eSpark-Consulting-Group/cooper-scarbrough-log-n-controller/Client-Files/Project Data_4.30.24/LogN Controller BOD REV1_4.20.24.pdf

Operator Engagement

1

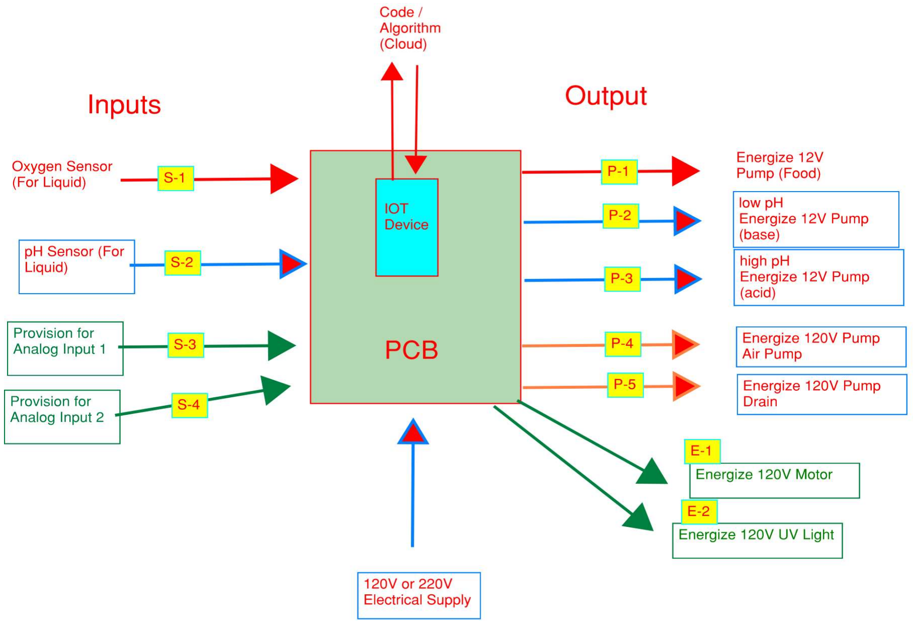
[picture p7: figure]

Operator Selects Script interacting with the Controller. (Simple Programmable Screen with Button Interface)
2

### 3 Operator Selects 'RUN' (Button Interface)

4

### 5 Script is followed per Parameters/Variables

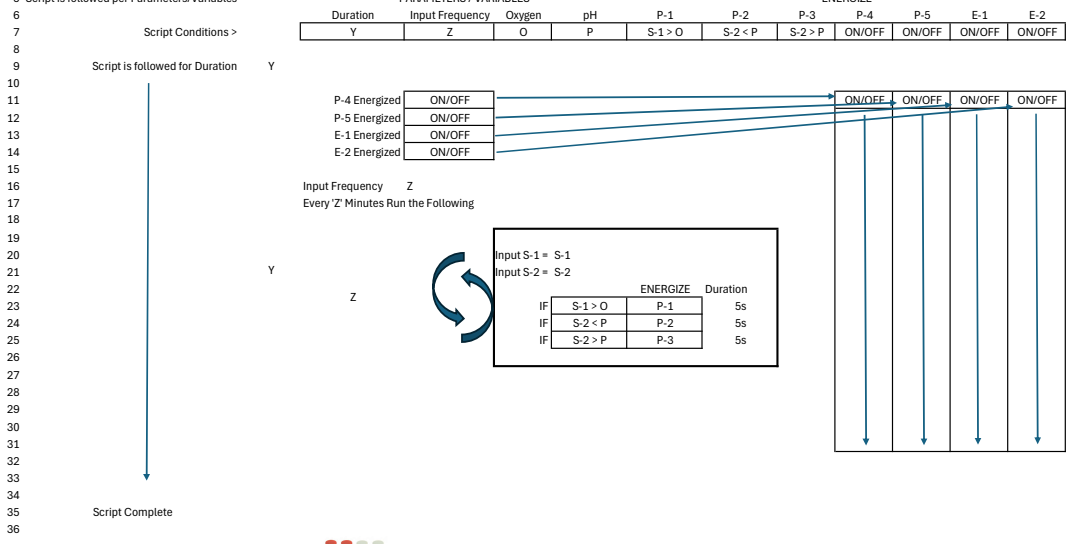
[picture p8: figure]
Duration; Input Frequency Oxygen; Script Conditions >; ON/OFF; Script is followed for Duration; P-4 Energized; P-5 Energized; E-1 Energized; E-2 Energized; Input Frequency; 17 Every 'Z' Minutes Run the Following 18 19 20 Input S-1 = S-1 21 Input S-2 = S-2 22 ENERGIZE Duration; 26 27 28 29 30 31 32 33 34 35 Script Complete 36

### 37 Operator Select 'END' to clear cache

ENERGIZE

CODE BASE
Parameters/Variables > | Duration | Input Frequency | Oxygen | pH | ENERGIZE
Script Name | Y | Z | O | P | P-1 | P-2 | P-3 | P-4 | P-5 | E-1 | E-2
Microbe 1 | | | | | S-1 > O | S-2 < P | S-2 > P | ON | ON | ON | OFF
Microbe 2 | | | | | S-1 > O | S-2 < P | S-2 > P | ON | ON | ON | OFF
Microbe 3 | | | | | S-1 > O | S-2 < P | S-2 > P | ON | ON | ON | OFF
CT-1 | | | | | S-1 > O | S-2 < P | S-2 > P | ON | ON | ON | OFF
CT-2 | | | | | S-1 > O | S-2 < P | S-2 > P | ON | ON | ON | OFF
Sterilization | n/a | n/a | n/a | n/a | n/a | n/a | n/a | OFF | OFF | ON | ON

PARAMETERS / VARIABLES

PERFORMANCE RUN
Code Base
