eSpark-Consulting-Group/cooper-scarbrough-log-n-controller/docs/Dev-Files/Production Enclosure Materials List/Cooper Panel Box Listing.docx

Cooper Panel Box Listing

1. Customised Acrylic window for LCD
2. Screen printing on front & side panel
3. Push Button knobs (Grey color) [10 Pcs]
4. M3x6mm & M3x10mm Male to Female standoff PCB Brass spacer [10 Pcs each]
5. U type 4mm Lugs [50 Pcs]
6. O type 4mm Lugs [50 Pcs]
7. Pipe 2.5mm Lugs [50 Pcs]
8. Lugs plier
9. Rivets M5x6mm & M3x6mm (Grey Color) [50 Pcs each]
10. Rivets plier
11. Glands PG9 & PG11 (Grey Color) [10 Pcs each]
12. 16x38mm Dura slot duct (Grey Color) Adamjee
13. Flexible pipe ½ inch & ¾ inch (Grey Color) [5 ft each] Adamjee
14. Spiral wrap ½ inch & ¾ inch (Grey Color) [5 ft each] Adamjee
15. Marker label tags (0-9 & A-Z)
16. Countersunk SS screw M3x5mm with SS nuts [24 Pcs each]
17. Round head SS screw M5x10mm [24 Pcs]
18. Industrial handle for Electrical panel box as per sample
19. Flexible wire 2.5mm & 10mm single core [10m each]
20. Stranded wire 4mm & 6mm [5m each]
21. Heat Shrink pipe (Red, Yellow, Blue and Black Color) [15 ft each]

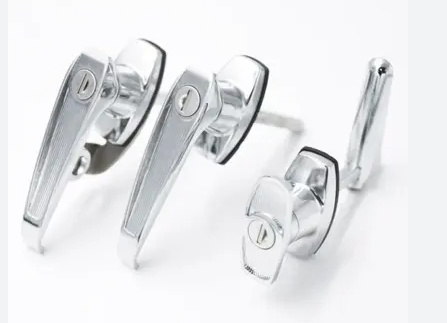
[picture p9: figure]
