eSpark-Consulting-Group/cooper-scarbrough-log-n-controller/Client-Files/Project Data_4.30.24/Production Data/BOM_Oxy_PH_Sensor_2024-04-30.csv

ID | Name | Designator | Footprint | Quantity | Manufacturer Part | Manufacturer | Supplier | Supplier Part | Price
1 | HDR-F-2.54_1x2 | H4,H5,H6,H2 | HDR-F-2.54_1X2 | 4 |  |  | LCSC | C49661 | 0.034
2 | 10kΩ | U15,U16,U17 | R0603 | 3 | PTFR0603B10K0N9 | RESI(开步睿思） | LCSC | C394535 | 0.142
3 | 10uF | C1,C5 | CAP-SMD_L3.5-W2.8-R-RD | 2 | CA45-B-25V-10uF-M | CEC(振华新云) | LCSC | C140404 | 0.124
4 | 100nF | C2,C4 | C0805 | 2 | CT41G-0805-2X1-50V-0.1μF-K(N) | TORCH(火炬) | LCSC | C126469 | 0.005
5 | 1nF | C3,C6 | CAP-TH_L8.5-W6.0_CT81-400VAC-08D-2E4-102M-YA | 2 | CT81-400VAC-08d-2E4-102M-YA 3.5d | LY(鲁颖) | LCSC | C2890520
6 | 100nF | C7 | CAP-TH_L18.0-W7.0-P15.00-D0.7 | 1 | X2-104K-275VAC | NDF(达孚) | LCSC | C914484 | 0.035
7 | DB128V-5.0-6P | CN1 | CONN-TH_6P-P5.00_DB128V | 1 | DB128V-5.0-6P-GN-S | DORABO(地博电气) | LCSC | C424686 | 0.475
8 | P4SMA15CA | D1 | SMA_L4.4-W2.6-LS5.0-BI | 1 | P4SMA15CA | Littelfuse(美国力特) | LCSC | C151192 | 0.127
9 | 210S-1*2P L=11.6MMGold-plated black | H1,H3 | HDR-TH_2P-P2.54-V-M-1 | 2 | B-2100S02P-A110 | Ckmtw(灿科盟) | LCSC | C124375 | 0.022
10 | Techtonics PH Sensor | J1 | HDR-M-2.54_1X6 | 1 |  |  | LCSC | C190819 | 0.029
11 | SEN0322 | J2 | HDR-M-2.54_1X4 | 1 |  |  | LCSC | C124378 | 0.04
12 | FC-HLF2018-15MH-10A-LF | L3 | FILTER-TH_4P-L22.0-W14.0-TL | 1 | FC-HLF2018-15mH-10A-LF | FC(方成) | LCSC | C5142780 | 2.062
13 | FTR14D471K | R1 | RES-TH_L16.0-W5.4-P7.50-D0.8-S4.60 | 1 | FTR14D471K | FTR(乔光电子) | LCSC | C693460 | 0.08
14 | 100Ω | R2,R3,R4,R5,R6,R7,R8,R9,R10,R11,R12,R13,R14,R15 | R0603 | 14 | QR0603F100RP05Z | EVER OHMS(天二科技) | LCSC | C176127 | 0.004
15 | SRD-05VDC-SL-C | RLY1,RLY2,RLY3,RLY4,RLY5,RLY6,RLY7 | RELAY-TH_SRD-XXVDC-XL-C | 7 | SRD-05VDC-SL-C | 松乐 | LCSC | C35449 | 0.306
16 | 0251004.NRT1L | U1,U6 | FUSE-TH_BD3.0-L7.2-P11.20-D0.6 | 2 | 0251004.NRT1L | Littelfuse(美国力特) | LCSC | C178929 | 0.158
17 | DB128L-5.0-2P-GY-S | U2 | CONN-TH_2P-P5.00_DB128L-5.0-2P-GY-S | 1 | DB128L-5.0-2P-GY-S | DORABO(地博电气) | LCSC | C430598 | 0.181
18 | TLP187(TPL,E(T | U3,U8,U9,U11,U12,U13,U14 | OPTO-SMD-4_L3.7-W4.6-P2.54-LS7.0-BR-2 | 7 | TLP187(TPL,E | TOSHIBA(东芝) | LCSC | C50180 | 0.433
19 | ESP32-DEVKITC-32D | U4 | COMM-SMD_ESP32-DEVKITC-32D | 1 | ESP32-DevKitC-32D | ESPRESSIF(乐鑫) | LCSC | C571181 | 12.402
20 | IRM-10-5 | U5 | PWRM-TH_4P-L45.7-W25.4-P8.0 | 1 | IRM-10-5 | MW(明纬) | LCSC | C2857903 | 5.115
21 | LDE15-20B12 | U7 | PWRM-TH_LDE15-20BXX | 1 | LDE15-20B12 | MORNSUN(金升阳) | LCSC | C970785 | 9.178
22 | DB128V-5.0-8P | U10 | CONN-TH_8P-P5.00_DB128V-5.0-8P | 1 | DB128V-5.0-8P-GN-S | DORABO(地博电气) | LCSC | C395863 | 0.567
23 | 4.7uH | L2 | IND-TH_BD7.0-P2.50-D0.7 | 1 | PK0608-4R7MB | SXN(顺翔诺) | LCSC | C400294 | 0.048
