eSpark-Consulting-Group/cooper-scarbrough-log-n-controller/Client-Files/Project Data_4.30.24/Schematic_Oxy_PH_Sensor_2024-04-30.pdf

AC-DC 5VDC | AC-DC 12VDC

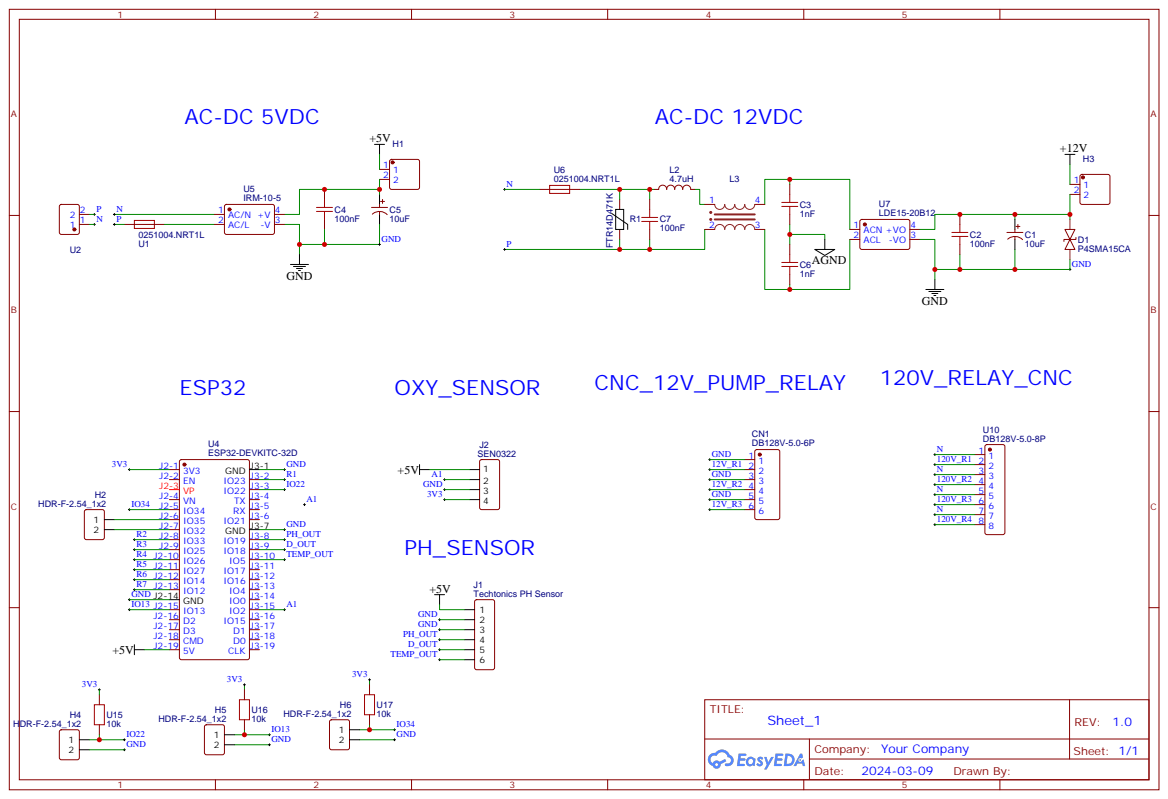
[picture p10: page 1]

# OPTO_12V_PUMP

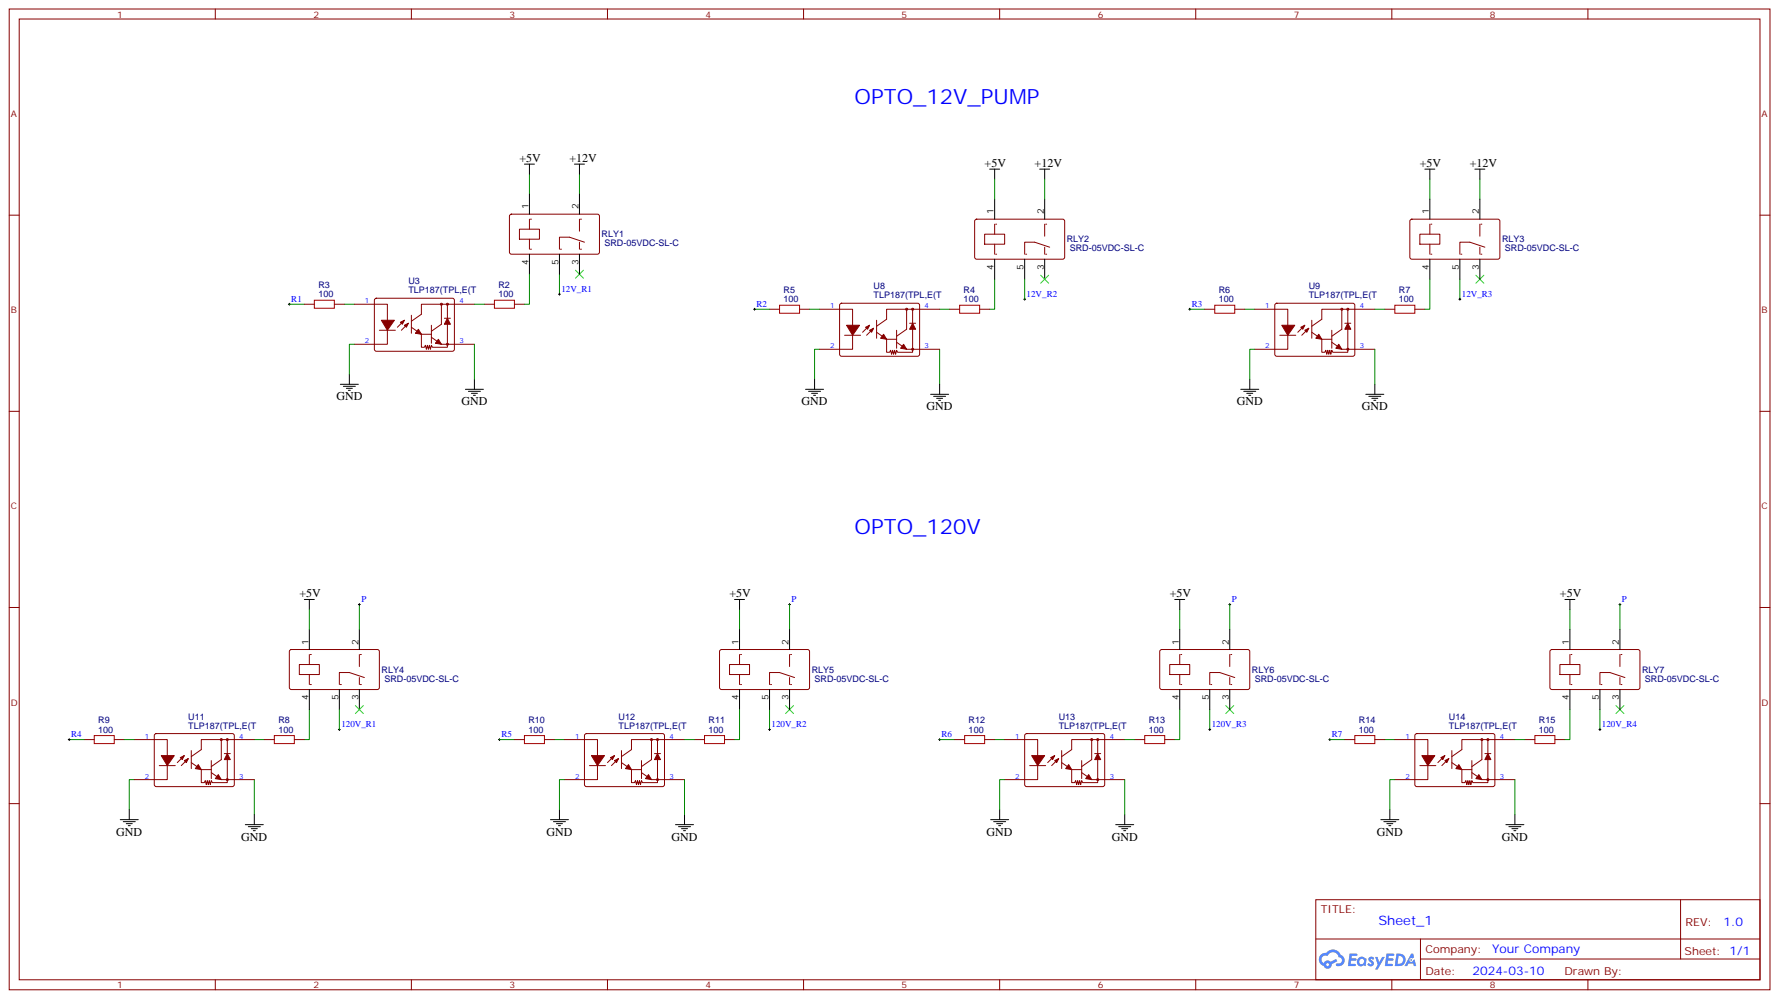
[picture p11: page 2]
