eSpark-Consulting-Group/cooper-scarbrough-log-n-controller/(list of files, drawings)

Other design files:
Client-Files/Project Data_4.30.24/Source File/SCH_Oxy_PH_Sensor_2024-04-30 (1).json
Client-Files/Project Data_4.30.24/Source File/SCH_Oxy_PH_Sensor_2024-04-30.json
